Cringely/ESP-Matter-Daikin-S21/Custom PCB esp32c6/3dmodels/XIAO-ESP32-C6-DIP.step

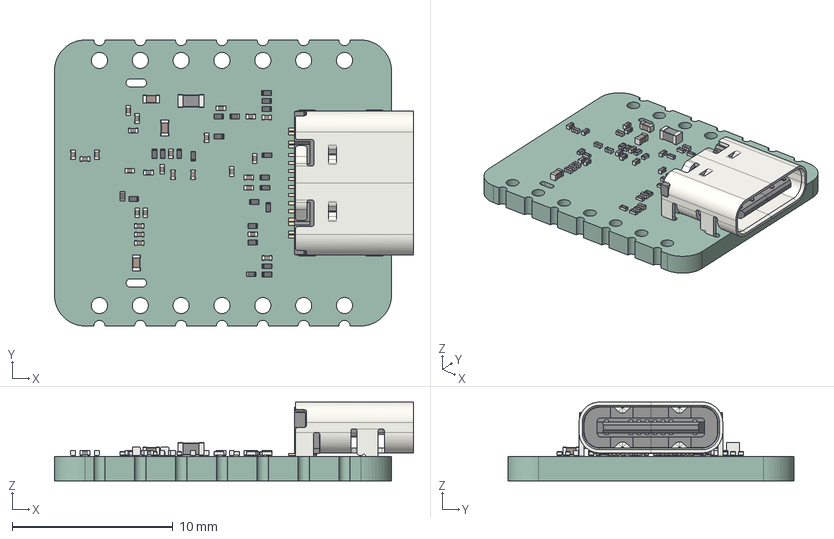
[picture p1: CAD file, 2026-07-21]
Custom PCB esp32c6/3dmodels/XIAO-ESP32-C6-DIP.step
22.3 x 17.8 x 4.91 mm
C_0201_0603Metric x 23
C_0402_1005Metric x 3
R_0201_0603Metric x 22
L_0201_0603Metric x 4
USB_C_Receptacle_16P_TopMnt_Horizontal_GCT_USB4105-xx-A
L_0603_1608Metric
XIAO ESP32 C6_PCB
