Cringely/ESP-Matter-Daikin-S21/Custom PCB esp32c6/fab-xiao/esp32c6_daikin-schematic.pdf

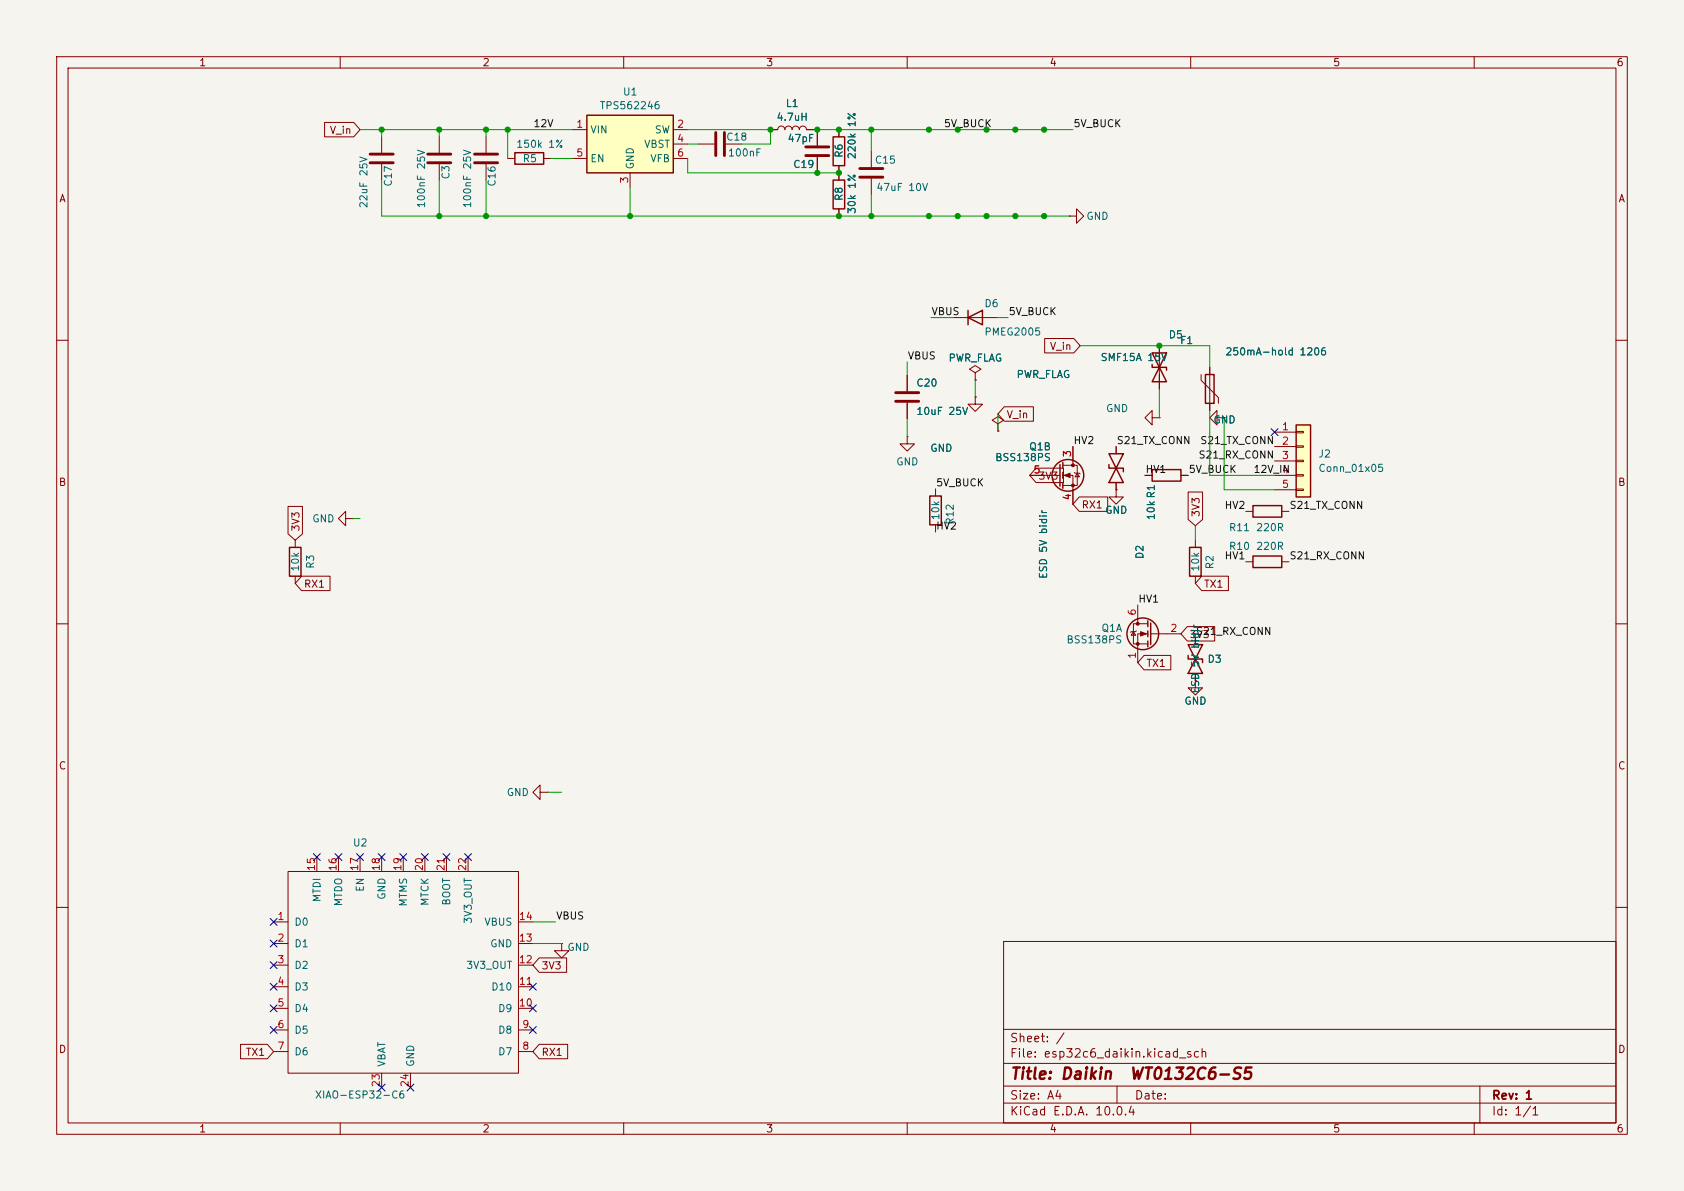
[picture p7: page 1]

Size: A4 | Rev: 1
KiCad E.D.A. 10.0.4 | Id: 1/1
