Cringely/ESP-Matter-Daikin-S21/Custom PCB esp32c6/esp32c6_daikin.kicad_pcb

## KiCad design Custom PCB esp32c6/esp32c6_daikin.kicad_pcb (2026-07-21)

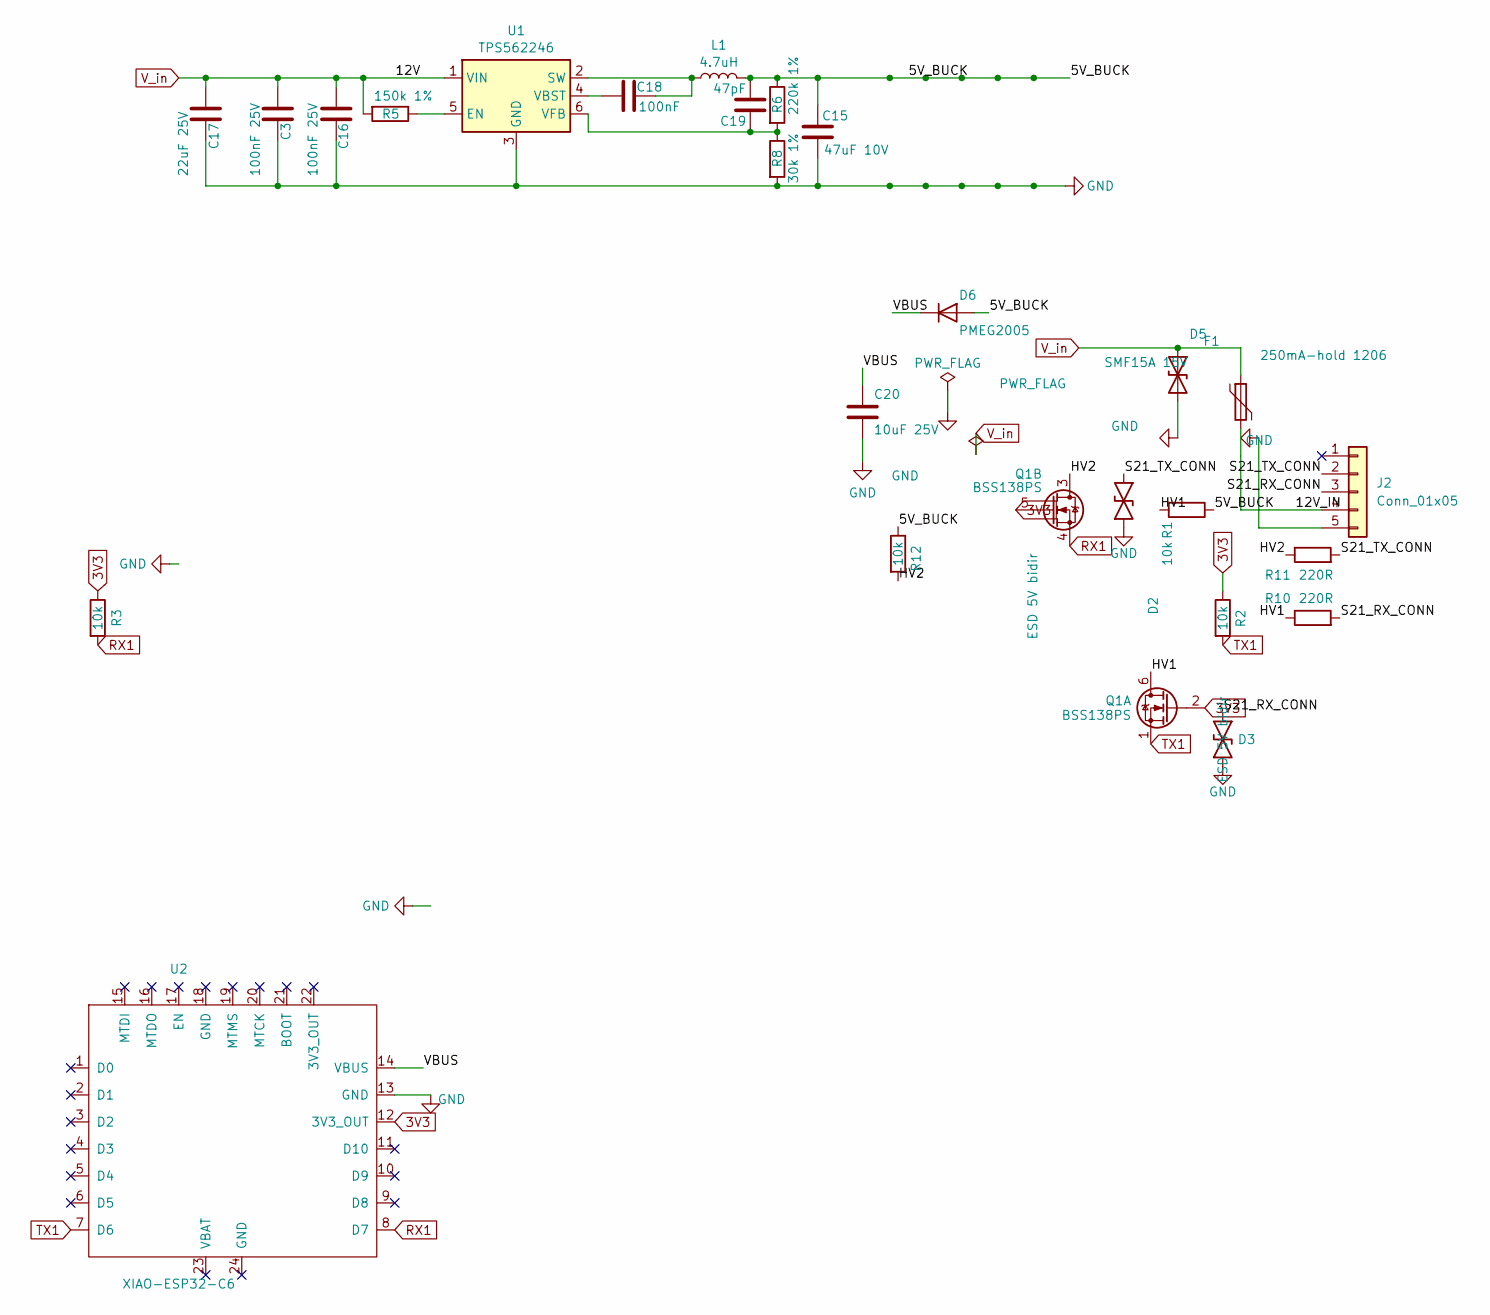
[picture p8: schematic esp32c6_daikin.kicad_sch, Daikin WT0132C6-S5]

Parts:
C3, C16: 100nF 25V; C0402; LCSC C307331
C15: 47uF 10V; C0805; LCSC C2292827
C17: 22uF 25V; C0805; LCSC C398931
C18: 100nF; C0402; LCSC C1525
C19: 47pF; C0402; LCSC C84706
C20: 10uF 25V; C0805; LCSC C15850
D2, D3: ESD 5V bidir; DFN1006-2L_L1.0-W0.6-P0.65-BI; MPN C5137770; LCSC C5137770
D5: SMF15A 15V; D_SOD-123F; LCSC C123802
D6: PMEG2005; D_SOD-123; LCSC C96233
F1: 250mA-hold 1206; Fuse_1206_3216Metric; LCSC C99561
J2: Conn_01x05; JST_EH_S5B-EH_1x05_P2.50mm_Horizontal; LCSC C265103
L1: 4.7uH; IND-SMD_L4.9-W4.9_NRS50XX; LCSC C307876
Q1: BSS138PS; SOT-363_L2.0-W1.3-P0.65-LS2.1-BR; MPN C193381; LCSC C193381
R1, R2, R12: 10k; R0402; MPN C25744; LCSC C25744
R3: 10k; R0402; LCSC C25744
R5: 150k 1%; R0603; LCSC C22807
R6: 220k 1%; R0603; LCSC C22961
R8: 30k 1%; R0402; LCSC C138008
R10, R11: 220R; R_0603_1608Metric; LCSC C1226
U1: TPS562246; SOT-5X3-6_L1.6-W1.2-P0.50-LS1.6-BR; LCSC C41833479
U2: XIAO-ESP32-C6; XIAO-ESP32-C6-DIP

Connections:
3V3: Q1.2 (GN), Q1.5 (GP), R2.1, R3.1, U2.12 (3V3_OUT)
/5V_BUCK: C15.1, C19.2, D6.2 (A), L1.2, R1.1, R6.1, R12.1
/12V_IN: F1.2, J2.4
/HV1: Q1.6 (DN), R1.2, R10.1
/HV2: Q1.3 (SP), R11.1, R12.2
/S21_RX_CONN: D3.2, J2.3, R10.2
/S21_TX_CONN: D2.2, J2.2, R11.2
/VBUS: C20.1, D6.1 (K), U2.14 (VBUS)
GND: C3.2, C15.2, C16.2, C17.2, C20.2, D2.1, D3.1, D5.2 (A2), J2.5, R8.2, U1.3 (GND), U2.13 (GND)
unnamed: R5.1, U1.5 (EN)
unnamed: C18.2, L1.1, U1.2 (SW)
unnamed: C18.1, U1.4 (VBST)
unnamed: C19.1, R6.2, R8.1, U1.6 (VFB)
RX1: Q1.4 (DP), R3.2, U2.8 (D7)
TX1: Q1.1 (SN), R2.2, U2.7 (D6)
V_in: C3.1, C16.1, C17.1, D5.1 (A1), F1.1, R5.2, U1.1 (VIN)

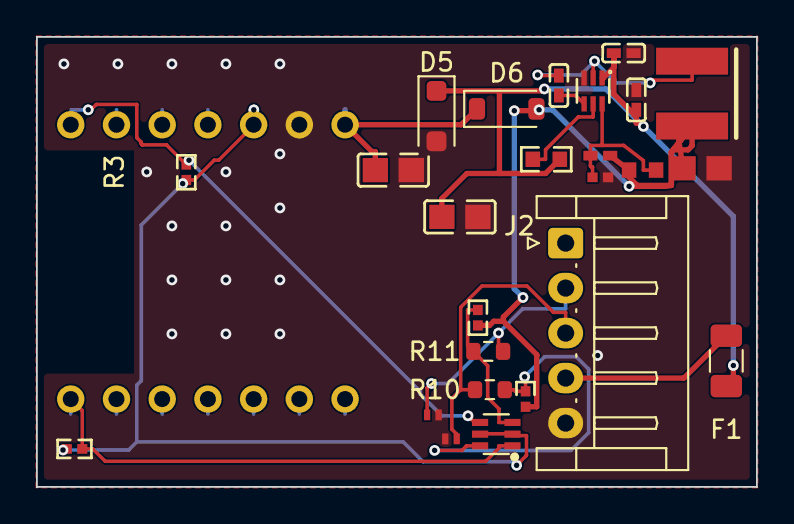
[picture p9: board esp32c6_daikin.kicad_pcb from above]

Board: 2 copper layers, 40.0 x 25.0 mm, 26 parts (1 on the bottom side), 16 nets.
