Cringely/ESP-Matter-Daikin-S21/(commit log)

2026-07-18 fix(drc): enforce 0.127mm minimum clearance and track width
    Board shipped with min_clearance and min_track_width zeroed, so KiCad's
    built-in checks passed vacuously. 0.127mm is the JLC 2-layer floor.
2026-07-18 fix(pcb): replace 91 per-net 1-mil floods with proper GND pours
    EasyEDA-import artifact zones ran 0.0254mm min width, a fifth of the JLC
    floor, risking slivers and coupling the buck SW node into the antenna.
    Routed tracks already carry all nets; only real GND pours remain at
    0.2mm min width with thermal relief.
    [esp32c6_daikin.kicad_pcb]
2026-07-18 fix(pcb): resolve starved thermal reliefs on five GND pads
    [esp32c6_daikin.kicad_pcb]
2026-07-18 fix(pcb): move Boot1 via clear of the board edge
    Sat 0.24mm from Edge.Cuts against a 0.5mm rule; edge routing tolerance
    could nick it. A plain perpendicular retreat wasn't viable: the via sits
    in a 1.05mm corridor between the U2 castellated pad row (0.6mm gaps
    between 2.0mm-pitch pads) and the board edge, too tight to gain edge
    clearance without shorting an adjacent pad. Relocated it into the same-net
    column under U2 pad 12 (161.4,109.03 -> 164.11,108.6) and re-terminated
    the two connected track segments there instead.
    Also hardened refill.py to disable wx assert dialogs (wx.DisableAsserts())
    so a stray pcbnew API nag (PCB_VIA::GetWidth called without a layer
    argument, hit while probing pad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
    [esp32c6_daikin.kicad_pcb]
2026-07-18 fix(sch): add 12V input PTC + TVS and S21 series resistors
    TPS562246 is 17V-rec/19V-abs-max on a 12-14V rail with no clamp; SMF15A
    clamps hot-plug ring near breakdown, under abs-max. PTC protects the
    aircon supply. 220R series resistors cap fault current into the level
    shift, per faikin32 baseline BOM.
    [esp32c6_daikin.kicad_sch]
2026-07-18 feat(sch): S21-standard keyed JST-EH connector
    Replaces the non-keyed 7-pin 0.1in header. Standard Daikin BRP069B41
    lead mates directly; keying provides the reverse-mate protection.
    Debug UART pins dropped; module USB covers debug.
    [esp32c6_daikin.kicad_sch]
2026-07-18 fix(bom): LCSC part numbers for all placeable parts
    U2 and J2 shipped blank and would arrive unplaced from JLC assembly.
    New protection parts included. BOM_rev-b.csv is the assembly BOM.
    [BOM_rev-b.csv, esp32c6_daikin.kicad_sch, task7-bom.csv]
2026-07-18 fix(pcb): place/route 12V protection + S21 series resistors; remove old header
    Sync + place + route the protection parts (F1 polyfuse, D5 SMF15A TVS,
    R10/R11 S21 series resistors) into the PCB and route them to existing copper.
    Old 7-pin J2 header is REMOVED in this commit rather than the connector
    commit: its courtyard and THT pads span x[173.87..186.17] over the full
    board height and occupy the only viable placement region for the protection
    parts. Any parts-first layout with the header present is DRC-verified to
    produce courtyard_overlap + shorting_items errors. The intermediate board
    state therefore has no connector by design; commit B adds the JST-EH and
    routes it to these parts. (Grou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
    [esp32c6_daikin.kicad_pcb]
2026-07-18 feat(pcb): JST-EH connector placement and routing
    Add the 5-pin JST-EH (S5B-EH horizontal) J2 on the right board edge, housing
    and keying facing off-board, pin1 at top. Route to the protection parts placed
    in commit A: J2.4->F1 (12V_IN, F.Cu), J2.2->R10 (S21_TX_CONN, B.Cu w/ one
    F.Cu via-hop over RX), J2.3->S21_RX_CONN (B.Cu), J2.5->GND (F.Cu pour); J2.1 NC.
    Removed 17 GND stitching vias from the connector rework region (x177.7-178.5,
    y90.5-104) that formed a wall between the connector pins and the protection
    parts. GND stays fully connected via the continuous F.Cu pour + the remaining
    stitching vias (DRC unconnected==0 confirms).
    Removed 7 stale old-header silk pin labels (GND/V_in/TX1/RX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
    [esp32c6_daikin.kicad_pcb]
2026-07-18 fix(sch+pcb): separate the two S21 signal nets merged by the JST-EH swap
    The Task-6 JST-EH connector swap merged two S21 nets into one, tying
    J2 pin 2 (aircon Tx) and J2 pin 3 (aircon Rx) together through R10 (220R)
    and feeding the ESP's TX back into its RX front end. A single wire carrying
    the /S21_RX_CONN label at the R10.1 row shorted J2.3, R11.2, and the
    Q1.2/D3/D4 gate cluster onto one 6-node net.
    This restores the Task-5 (commit 2981aef) two-net split, adapted to the new
    JST-EH pin numbers:
    - /S21_TX_CORE (new label; was Net-(D4-K)) = {R10.1, Q1.2, D3.2, D4.1}
    - /S21_RX_CONN (reduced to) = {J2.3, R11.2}
    J2.2 and J2.3 now share no path except through the intended ful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
    [esp32c6_daikin.kicad_pcb, esp32c6_daikin.kicad_sch]
2026-07-19 chore(rev-b): fab package (gerbers + drill + pos) for the module board record
    Design is DRC-clean and reviewed; generated the fab package to answer
    whether rev-b was truly fab-ready (it is, at the design level). The
    board is superseded by the XIAO carrier (see faikin32 spec), so rev-b
    stays as a record with its complete fab package attached.
    [esp32c6_daikin-B_Courtyard.gbr, esp32c6_daikin-B_Cu.gbl, esp32c6_daikin-B_Fab.gbr, esp32c6_daikin-B_Mask.gbs, esp32c6_daikin-B_Paste.gbp, esp32c6_daikin-B_Silkscreen.gbo, esp32c6_daikin-Edge_Cuts.gm1, esp32c6_daikin-F_Courtyard.gbr]
2026-07-19 feat(xiao-sch): delete WT0132C6 module + button circuitry
    [esp32c6_daikin.kicad_sch]
2026-07-19 feat(xiao-sch): add XIAO ESP32-C6 symbol + both-capable footprint
    Add U2 = Seeed XIAO ESP32-C6, reusing the reference designator freed
    by the Task 2 module deletion. Not wired yet (Tasks 4/5 wire UART and
    power); pins left ready.
    Source: official Seeed OPL KiCad library (Seeed-Studio/OPL_Kicad_Library,
    "Seeed Studio XIAO Series Library"). Symbol XIAO-ESP32-C6-SMD (24 pins)
    and footprint XIAO-ESP32-C6-DIP copied verbatim into a project-local lib
    (lib/Seeed_Studio_XIAO_Series.kicad_sym, lib/Seeed_XIAO.pretty) with new
    sym-lib-table / fp-lib-table.
    Footprint is both-capable by construction: each of the 14 main edge pads
    has BOTH a plated through-hole (header/socket mount) and an outward SMD
    e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
    [esp32c6_daikin.kicad_sch]
2026-07-19 feat(xiao-sch): non-inverting AN10441 level shifter + XIAO UART
    Replace the old common-source (INVERTING) BSS138PS shifter with the
    hardware-validated non-inverting NXP AN10441 gate-shifter, and wire the
    XIAO ESP32-C6 UART + power.
    Per channel: gate->3V3, source->LV (TX1/RX1, 10k pull-up to 3V3),
    drain->HV (10k pull-up to 5V_BUCK) -> 220R (R10/R11) -> J2. Crossed so
    XIAO TX (D6) drives aircon Rx (J2 pin3) and aircon Tx (J2 pin2) drives
    XIAO RX (D7). Firmware stays invert:false.
    - Q1 rewired to AN10441; all vestiges of the inverting wiring removed
    (Q1 source/drain no longer to GND; old /S21_TX_CORE + Q1B-SP nets gone).
    - Four 10k pull-ups: R2/R3 kept on 3V3 (LV), R1 repurposed + R12 added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
    [esp32c6_daikin.kicad_sch]
2026-07-19 fix(xiao-sch): correct FET-2 source/drain swap in level shifter
    Q1 (BSS138PS dual N-MOSFET) channel 2 had RX1/HV2 on the wrong pins.
    The RevK symbol names pin 3 "SP" and pin 4 "DP" as if pin3=source,
    pin4=drain, but the Nexperia BSS138PS datasheet Table 2 gives the
    physical pinout as pin 3 = Drain 2, pin 4 = Source 2 (symbol names are
    transposed vs the datasheet). Task 4 wired channel 2 by the symbol's
    names, so the low-voltage line (RX1) landed on the physical drain and
    the 5V line (HV2) on the physical source, backwards for an AN10441
    shifter and opposite to the correct channel 1.
    Fix: swap the two labels at Q1 pins 3/4 so RX1 (LV, to XIAO D7) sits on
    pin 4 (physical Source 2) and HV2 (HV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
    [esp32c6_daikin.kicad_sch]
2026-07-19 feat(xiao-sch): buck 5V re-tune, VBUS isolation diode, cap re-home
    Re-tune TPS562246 buck 3.3V->5.0V, split the merged 3V3 net, add the
    USB-back-feed isolation Schottky, and clear all ERC errors (29->0).
    Divider (datasheet SLUSFG8A Vref=0.600V typ, Table 7-2 5V row):
    R6 150k->220k, R8 33k->30k, C19 18pF->47pF => Vout=0.600*(1+220/30)=5.000V.
    Note: the brief's "Vref~0.804V, Vout~4.46V" premise was wrong; Vref is 0.600V
    and the old divider gave 3.33V (this was a 3.3V buck). Confirmed 5V within the
    0.6-7V output range and 12V within the 4.2-17V input range.
    Net split (verified by netlist node-set, not coordinates):
    Buck-output rail label 3V3(global)->5V_BUCK(local), merging with R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
    [esp32c6_daikin.kicad_sch]
2026-07-19 fix(xiao-sch): drop dead-end ferrite, decouple XIAO VBUS with C20
    FB1 (ferrite) fed C20 in a shunt off 5V_BUCK that dead-ended at GND -
    it filtered nothing downstream, flagged by two EDA reviewers. Deleted
    FB1 and re-homed C20 to decouple the XIAO VBUS pad (post-Schottky D6)
    instead: C20.1 -> VBUS, C20.2 -> GND (unchanged).
    Also cleaned up 10 dangling wire-endpoint stubs left from the Task 5
    buck-rail rehoming (verified via ERC ground truth, not just the
    approximate coordinate list in the task brief - found a 5th affected
    column the brief missed), and corrected U1's stale TPS562246
    description (580kHz/0.804V-7V -> 1.28MHz/0.6V-7V per datasheet
    SLUSFG8A) that had misled an earlier review.
    N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
    [esp32c6_daikin.kicad_sch]
2026-07-19 feat(xiao-pcb): place XIAO + kept parts on grown outline
    Sync the PCB to the reviewed XIAO-carrier schematic (Task 7, placement only;
    routing is Task 8).
    - Remove 12 footprints no longer in the netlist (Reset1, Boot1, Matter1, D4,
    R9, C1, C2, C4, C5, C6, C7, C8).
    - Swap U2 from the old module footprint (easyeda2kicad:WT0132C6-S5) to the
    Seeed XIAO land pattern (Seeed_XIAO:XIAO-ESP32-C6-DIP).
    - Add the 3 new parts: U2 XIAO, D6 (PMEG2005 VBUS Schottky, D_SOD-123),
    C20 (10uF XIAO VBUS decap), R12 (10k). No ferrite (dropped in schematic).
    - Reassign every pad net from the exported netlist (89 pads, 0 mismatches,
    full ref-set parity).
    - Grow the outline to 40x25 mm. Place U2 on B.Cu at t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
    [esp32c6_daikin.kicad_pcb, xiao-task7-padnet-parity.csv]
2026-07-19 fix(xiao-pcb): sync board value fields + footprint lib ids to schematic
    Follow-up to 542d1fc, from independent review. The net-level sync propagated
    nets and footprints but not component value fields, leaving four parts with
    stale rev-b values on the board:
    - R6 150k -> 220k (buck feedback divider; sets Vout)
    - R8 33k -> 30k (feedforward)
    - C19 18pF -> 47pF (feedforward cap)
    - C15 47uF 6V3 -> 47uF 10V (output cap voltage rating)
    These are the Task-5 buck retune values (Vout 5.000 V per TI Table 7-2). A BOM
    cut from the PCB would otherwise place the wrong buck parts. Values now match
    the schematic netlist for all 26 footprints.
    Also set the library nicknames on the two lib-loade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
    [esp32c6_daikin.kicad_pcb, xiao-task7-padnet-parity.csv]
2026-07-19 fix(xiao-pcb): extend antenna keep-out to cover on-board antenna projection
    XIAO_antenna_keepout only extended to x=150.82 (0.82mm inside the board
    edge at x=150). Seeed does not publish an exact antenna dimension for the
    XIAO ESP32-C6 onboard ceramic antenna (checked wiki.seeedstudio.com getting-started
    page, forum antenna-comparison thread, and the bundled Seeed_XIAO footprint,
    none give a figure); Espressif's ESP32-C6 PCB layout guideline only gives a
    15mm end-product enclosure clearance, not a carrier-board copper keepout.
    Using the conservative XIAO-family convention (antenna region occupies the
    outer 5-6mm of the 21mm module) plus margin: keepout now runs to x=155.5,
    about 6.5mm in fro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
    [esp32c6_daikin.kicad_pcb]
2026-07-19 fix(xiao-pcb): notch antenna keep-out clear of TX1/RX1 pad rows
    Re-review found the prior keepout extension (150.82->155.5, full board
    depth) engulfed U2.7/TX1 and U2.8/RX1 pad copper at x=151.88: every
    routing escape from those pads crossed the tracks-not-allowed zone,
    making them unroutable in Task 8.
    Reworked to a T-shaped polygon: full-depth band only to x=150.3 (0.36mm
    clear of the widest TX1/RX1 pad edge at x=150.664, > 0.3mm min), then
    extended coverage to x=155.5 only in the y=92.2-104.8 center band between
    the two pad rows (measured pad-row inner edges 105.358 top / 91.642
    bottom, 0.56mm clearance each side, > 0.5mm min). Trades full-width
    antenna coverage near the board edge for r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
    [esp32c6_daikin.kicad_pcb]
2026-07-19 fix(xiao-pcb): move center-gap passives out of antenna keep-out
    Re-review flagged R1, R2, C16 as a Task 7 placement defect, not a Task 8
    routing note: parts sitting under the antenna region is poor RF practice
    independent of the keepout's tracks/copperpour ban. Verified by geometry
    (pad + courtyard bboxes vs the keepout polygon, both rule-area rects) that
    these three were the complete offender set beyond U2 itself.
    Relocated, preserving layer/orientation:
    - R1 (5V_BUCK/HV1, shifter HV-side pull-up) to (177.147,106.118), next to
    the Q1/R10/R11 shifter cluster it belongs to.
    - R2 (3V3/TX1 pull-up) to (152.089,108.891), just off U2's bottom edge,
    ~2.4mm from the TX1 pad it serves, clear of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
    [esp32c6_daikin.kicad_pcb]
2026-07-19 fix(xiao-pcb): re-place buck support passives per datasheet layout
    Move C3/C17 input caps, C18 bootstrap, R6/R8/C19 feedback divider,
    C15 output cap tight to U1/L1 in the top-right buck cluster; C20 VBUS
    cap to the XIAO VBUS pin; R12 pull-up to the HV2 node at Q1/R11.
    Clears the XIAO center-gap of buck nets (root cause of the prior
    2-net routing block) and shortens SW/bootstrap/feedback loops per the
    TPS562246 layout guidance. Placement DRC (courtyard/short) clean.
    [esp32c6_daikin.kicad_pcb]
2026-07-20 fix(xiao-pcb): unseal U1 VFB pad exit (nudge C16 east 0.4mm)
    The VFB sense pin U1-6 was physically sealed at OSH Park 6-mil clearance:
    its only lateral exit (rightward) was pinched between the C18-2/SW pad halo
    (right edge 181.645, +0.2286 halo = 181.874) and the C16-1/V_in pad halo
    (left edge 182.009, -0.2286 halo = 181.780). The two halos overlapped
    (181.780 < 181.874), leaving no gap, so no trace or via could leave the pad.
    Three independent routers (maze, Freerouting push-shove x10 runs, A* finisher)
    plus closed-form geometry all confirmed U1-6 could not be exited.
    Fix: move C16 (VIN input decoupler) 0.4mm east, 182.279 -> 182.679 (x only,
    y unchanged). This opens a 0.306mm (2x trace-wi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
    [esp32c6_daikin.kicad_pcb]
2026-07-20 fix(xiao-pcb): re-layout buck cluster with per-net routing corridors
    The TPS562246 (U1, SOT-23-6, 0.5mm pitch) buck cluster could not route at
    the board's 0.2mm track-to-pad DRU rule: three middle/edge pins (SW, EN, VFB)
    over-subscribed a single ~0.3mm corridor. Re-laid out the cluster so each hard
    pin gets its own >=0.2mm-clean escape, budgeted geometrically before placing.
    U1 kept at 180.9,89.0 rot90; corridors cleared:
    - SW (U1-2, top-mid) exits up into a clear strip y[86.5,87.8] -> C3 moved off
    the SW column: C3 180.9,87.05 -> 181.9,86.9 (VIN cap now above VIN pin U1-1).
    - EN (U1-5) / VFB (U1-6) / VBST (U1-4) exit down into a cleared fan-band
    y[90.3,92.3] -> the FB divider + bootst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
    [esp32c6_daikin.kicad_pcb]
2026-07-20 feat(xiao-pcb): route, pour, DRC clean, OSH Park 6-mil verified
    Full 2-layer routing on the re-laid-out buck cluster. All 15 signal/power nets
    route at the board's own DRU rules (0.2mm track-to-pad, 0.127mm track-track,
    0.33mm track-to-hole, 0.3mm edge). Power nets (5V_BUCK, VBUS, V_in, 12V_IN)
    on a Power netclass at 0.3mm width. Antenna keep-out respected (no tracks in
    the polygon); TX1/RX1 escape through the keep-out notch; S21 traces clear of L1.
    GND: solid pour both layers, stitched with vias, single connected plane tied to
    the star point J2-5; F.Cu island under the buck output tied through a via.
    Toolchain (portable, not committed): Freerouting 2.2.4 on Temurin JRE 25.0.3+9,
    DSN/SES v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
    [esp32c6_daikin.kicad_pcb]
2026-07-20 test(xiao-pcb): commit OSH Park 6-mil DRC evidence
    Review found the 6-mil verification ran only in scratch space with no
    committed artifact. Reproduced on a byte-identical copy of the eda8131
    board with all custom clearance rules and both netclass clearances
    patched to 0.1524mm: 0 violations, 0 unconnected. Method note documents
    the rule-patch set, superseding the earlier floor-only check.
2026-07-20 review(xiao-pcb): delegated DFM review
    Apply the two required fixes from the delegated pcb-dfm-reviewer pass
    (verification/xiao-pcb-review.md, verdict READY-WITH-FIXES) before
    gerber export.
    F1: dedupe stacked stitching vias. 17 GND stitch points each carried
    6 co-located identical vias (0.3mm drill / 0.6mm pad), 85 redundant
    drill hits total. Kept one via per location: 124 -> 39 vias (17 GND
    stitch + 22 signal). Eliminates all 199 holes_co_located warnings.
    F2: delete dangling stub on /5V_BUCK. Removed the reviewer-identified
    4.868mm F.Cu run (183.432,100.262)-(179.989,103.705). Deleting it
    exposed a second segment (179.989,103.705)-(177.769,103.705), 2.221mm,
    that was only "terminated" b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
    [esp32c6_daikin.kicad_pcb]
2026-07-20 fix(xiao-sch): assign D2/D3 sourceable values
    D2/D3 protect the S21 TX/RX lines to GND (LCSC C5137770 = GOODWORK
    ES05D1MC10, bidirectional 5V ESD/TVS, DFN1006-2L). Value fields were
    blank; set to 'ESD 5V bidir'. Metadata only, no wiring change: netlist
    node-sets byte-identical (36 nets, 0 changed), ERC 0 errors, DRC
    schematic-parity 0.
    [esp32c6_daikin.kicad_sch]
2026-07-20 fix(xiao-sch): correct stale rev-b LCSC part numbers
    The XIAO board inherited four LCSC assignments from rev-b whose parts no
    longer match the updated values, plus one obsolete part. JLC and any
    regenerated BOM assemble by LCSC number, so these would mis-build the board:
    R6 C22807 (150k) -> C22961 (220k 1% 0603) buck FB top, sets Vout
    R8 C25779 (33k) -> C138008 (30k 1% 0402) buck FB bottom, sets Vout
    C15 C16780 (6.3V) -> C2292827 (47uF 10V 0805) buck out; 6.3V fails DC-bias
    C19 C1549 (18pF) -> C84706 (47pF C0G 0402) buck feedforward
    C17 C45783 (obsolete) -> C398931 (22uF 25V 0805 Murata GRT, in stock)
    Metadata only, no wiring change: netlist node-sets byte-identic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
    [esp32c6_daikin.kicad_sch]
2026-07-20 feat(xiao): fab package + sourceable BOM
    Gerbers (2-layer), Excellon drill, centroid pos CSV, and top/bottom
    renders for the XIAO ESP32-C6 carrier, exported with kicad-cli 10.0.4 at
    the DRC-clean board. Plus BOM_xiao.csv: every SMD part carries an LCSC
    number and a web-verified DigiKey/Mouser cross; the XIAO module (U2) is
    marked DNP-by-fab / hand-assembled.
    Note: gerbers are provisional. A silkscreen cleanup pass will touch the
    board file after this lands; regenerate gerbers from the post-silk board
    before uploading to a fab. Copper/drill/placement are final.
    [BOM_xiao.csv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]
2026-07-20 fix(xiao-pcb): silkscreen legibility pass + fab package refresh
    Drove all silkscreen DRC to zero and fixed U2's undersized reference
    designator, then regenerated the fab package. Silk graphics and
    reference text only; no copper, tracks, vias, or zones changed.
    DRC warnings (full run) before -> after:
    silk_overlap 55 -> 0
    silk_over_copper 29 -> 0
    silk_edge_clearance 2 -> 0
    text_height 1 -> 0
    text_thickness 1 -> 0
    Residual non-silk warnings are pre-existing/expected and non-gating:
    19 lib_footprint_issues, 2 hole_to_hole, plus 1 new lib_footprint_mismatch
    (U2's board-embedded footprint silk was edited so it no longer matches
    its library copy - intended).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
    [esp32c6_daikin-B_Courtyard.gbr, esp32c6_daikin-B_Cu.gbl, esp32c6_daikin-B_Fab.gbr, esp32c6_daikin-B_Mask.gbs, esp32c6_daikin-B_Paste.gbp, esp32c6_daikin-B_Silkscreen.gbo, esp32c6_daikin-Edge_Cuts.gm1, esp32c6_daikin-F_Courtyard.gbr]
2026-07-20 fix(xiao): correct D5 DigiKey cross + BOM sourcing notes
    D5: SMF15ALFCT-ND does not exist at DigiKey (fabricated); replaced with
    F5817CT-ND, the verified Littelfuse SMF15A cross for the LCSC MDD-brand
    primary (C123802).
    C15: DK P/N column cited the 15L reel-variant number under a 15K MPN;
    these are distinct DigiKey part numbers, not a formatting difference.
    Harmonized to the 15K DK number matching the sourced MPN.
    D6: noted DK 1157665 backorder status; LCSC C96233 remains in stock.
    J2: noted canonical DK 455-1628-ND alongside the 455-S5B-EH-ND alias
    (both verified to resolve to the same JST S5B-EH right-angle header).
    [BOM_xiao.csv]
2026-07-20 chore(xiao): final-review metadata cleanup
    Applies the mechanical items from final review that survived verification:
    1. LCSC fields added: D6 -> C96233, C20 -> C15850 (metadata only).
    2. NOT applied. Review flagged two micro wire stubs (0.0127mm/0.0254mm,
    UUIDs 30fba69b.../d927969b...) as unconnected_wire_endpoint ERC
    warnings safe to delete. Verified false: each stub is the sole
    graphical connection for a GND power symbol (#PWR06, #PWR017).
    Deleting them leaves those pins with zero attached wires, which
    flips ERC from 0 errors/72 warnings to 2 errors (pin_not_connected).
    The <nets> netlist section is unaffected either way (power-symbol
    global-label net forms independ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
    [esp32c6_daikin.kicad_sch]
2026-07-20 fix(xiao-pcb): clear keep-out boundary via, enforce no-vias in antenna zone
    Prior review claimed XIAO_antenna_keepout was via-free, so flipping its
    keepout vias allowed -> not_allowed was believed copper-inert. False:
    GND stitch via 326f1585 sat at (155.5, 93.5), exactly on the zone's
    right edge (x=155.5, y 92.2-104.8). The reviewer's center-point test
    passed because the via's *center* is on the boundary line, not inside
    the polygon; DRC's actual check tests full pad/via copper extent
    (0.6mm diameter disc), which straddles the edge and triggered
    items_not_allowed the moment vias were disallowed.
    Fix: moved the via 0.6mm east to (156.1, 93.5), same GND stitching
    net/role, position not critic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
    [esp32c6_daikin.kicad_pcb]
2026-07-20 chore(xiao): regenerate fab package after keep-out via fix
    Via 326f1585 moved east of the antenna keep-out (060567f) reflowed both
    GND pours; gerbers, drill, pos, and renders re-exported so the committed
    package matches HEAD copper exactly.
    [esp32c6_daikin-B_Courtyard.gbr, esp32c6_daikin-B_Cu.gbl, esp32c6_daikin-B_Fab.gbr, esp32c6_daikin-B_Mask.gbs, esp32c6_daikin-B_Paste.gbp, esp32c6_daikin-B_Silkscreen.gbo, esp32c6_daikin-Edge_Cuts.gm1, esp32c6_daikin-F_Courtyard.gbr]
2026-07-21 fix(xiao-sch): schematic legibility pass
    Text/layout-only pass; electrical design untouched. Moved refdes/value
    fields and power-symbol GND/PWR_FLAG text out of overlapping piles into
    open space; reoriented rotated-symbol fields (D5/F1/R10/R11) to read
    horizontally; fixed XIAO TX1 label overrunning the D6 pin name and the
    3V3/GND collision on pins 12-13; decluttered the V_in/PWR_FLAG/GND stub
    corner.
    Regions cleaned: buck input (already clean, verified), protection cluster
    value/refdes piles, V_in/flag stub corner, XIAO U2 pin labels.
    Residual: the J2 connector net-label band (S21_TX_CONN/S21_RX_CONN/HV1/
    HV2/12V_IN/5V_BUCK) remains dense. Each net carries three load-bearing
    labels sitting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
    [esp32c6_daikin.kicad_sch]
2026-07-21 fix(xiao-pcb): FB cluster spacing to real margins + mask-web enforcement
    Open the two tightest buck-feedback pad gaps to real v1 margins and turn on
    the OSH Park mask-web floor so DRC enforces it.
    Item A (copper):
    - C19.2<->R6.1 (both /5V_BUCK): 0.100mm -> 0.269mm (target >=0.25).
    - R8.2<->R6.1 (GND vs /5V_BUCK): 0.230mm -> 0.480mm (target >=0.30).
    R6 is boxed on all four sides (C19 N same-net, R8 W GND, C15 E, and the
    5V_BUCK output web S at y94.1). R6-south and C19-north/west both re-seal a
    corridor (the 5V_BUCK output web / the VFB sense trace). The clean move is
    R6 + C15 east 0.25mm together, shifting the 5V_BUCK output east-wall track
    (+0.30) and translating the VFB feed segment east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
    [esp32c6_daikin.kicad_pcb]
2026-07-21 fix(xiao-sch): J2 label band symbol repositioning
    The connector label band garbled: same-net 11-char labels on adjacent stubs
    (two "S21_TX_CONN" on J2 pin2's row, two "S21_RX_CONN" on pin3's row) overlapped
    because R10/R11 (the 220R pull-ups) sat directly in the connector label lane,
    each adding a duplicate net label that collided with the J2 pin label.
    Relocate R11 and R10 out of the lane to their own rows below the connector,
    carrying their pin labels (HV2/S21_TX_CONN, HV1/S21_RX_CONN) with them, and flip
    the J2 pin labels' justify so they read into the vacated lane instead of over the
    connector body. Both resistors connect only via net-name labels on their pins (no
    attached wires), so re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
    [esp32c6_daikin.kicad_sch]
2026-07-21 chore(xiao): regenerate fab package + renders
    Regenerate the full fab package from the final board (FB-cluster spacing +
    mask-web enforcement) and schematic (J2 band repositioning):
    - gerbers/ RS-274X set + Excellon drill + job file
    - esp32c6_daikin-xiao.pos.csv placement/centroid
    - xiao-render-top.png / -bottom.png board renders
    - esp32c6_daikin-schematic.pdf
    Copper, mask, placement, renders, and schematic PDF all reflect the polished
    board and schematic. Upload the gerbers to the fab, not the .kicad_pcb.
    [esp32c6_daikin-B_Courtyard.gbr, esp32c6_daikin-B_Cu.gbl, esp32c6_daikin-B_Fab.gbr, esp32c6_daikin-B_Mask.gbs, esp32c6_daikin-B_Paste.gbp, esp32c6_daikin-B_Silkscreen.gbo, esp32c6_daikin-Edge_Cuts.gm1, esp32c6_daikin-F_Courtyard.gbr]
2026-07-21 feat(xiao): xlsx BOM for US assembly quoting
    Screaming Circuits requires xlsx BOM format. Grouped one line per part
    type (20 lines, 26 placements), qty + refdes list + mfr + MPN + DigiKey/
    Mouser P/N, U2 marked DO NOT PLACE (customer-installed XIAO module).
    Generated from BOM_xiao.csv; CSV remains the source of truth.
    [BOM_xiao.xlsx]
2026-07-21 feat(xiao): JLCPCB-format BOM and CPL
    JLC's processor rejects raw KiCad pos/BOM formats. CPL matches their
    sample schema exactly (mm-suffixed Mid X/Y, Y negated positive, Top/
    Bottom, integer rotation); BOM uses Comment/Designator/Footprint/LCSC.
    U2 excluded from both (customer-installed XIAO). Generated from the
    CSV sources of truth.
    [BOM_xiao_jlc.xlsx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]
2026-07-21 fix(xiao): C17 to Murata GRM21BR61E226ME44L (LCSC C86816)
    User-selected at JLC assembly order; prior C398931 unavailable in their
    matcher. Same 22uF/25V/X5R/0805 class, verified on JLC part page.
    Regenerated xlsx and JLC-format BOMs from the CSV source.
    [BOM_xiao.csv, BOM_xiao.xlsx, BOM_xiao_jlc.xlsx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]
2026-07-21 feat(xiao): sync BOM to as-ordered JLC assembly parts
    Order finalized 2026-07-21, 5 boards. Fee-free swaps verified by research
    pass: D2/D3 H5VL10B (5V bidir 15pF), D5 Hongjiacheng SMF15A, D6 B0520W
    (Vf~385mV parametric, datasheet check flagged). C17/C19/R8/R10/R11 moved
    to in-stock Basic parts, R8 corrected to 30k after a 1k mismatch in the
    matcher. C15 stays Murata C2292827 (only 47uF/10V option with published
    DC-bias data). Original design parts retained in notes as DigiKey
    sourceable alternates. Placement-preview polarity check passed for
    D5/D6/U1/Q1 against board pad nets.
    [BOM_xiao.csv, BOM_xiao.xlsx, BOM_xiao_jlc.xlsx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]
2026-07-21 docs(xiao): D6 B0520W Vf verified from datasheet curve
    [BOM_xiao.csv, BOM_xiao.xlsx]
2026-07-21 feat(xiao): XIAO 3D model + assembled renders, refresh fab zip
    Derive a XIAO ESP32-C6 STEP model from Seeed's own officially
    published KiCad PCB design source (wiki resources zip) via
    kicad-cli pcb export step, re-centered on the module's own board
    outline. Seeed's own kicad footprint library (OPL_Kicad_Library /
    the wiki KiCad-Library zip) ships the XIAO-ESP32-C6-DIP footprint
    with broken ${AMZPATH} 3D model references pointing at other XIAO
    variants (nRF52840/SAMD21/RP2040/ESP32-C3/ESP32S3), none C6-specific
    and none resolvable; those are removed and replaced with the
    derived model. Seeed's own wiki 3D-model link for the C6 resolves
    to a login-gated third-party GrabCAD upload, not a first-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
    [XIAO-ESP32-C6-DIP.step, esp32c6_daikin.kicad_pcb]
2026-07-21 docs(xiao): correct order status to cart-staged, not placed
    The JLC walkthrough was a part-picking exercise; no order has been
    placed. Prior commit dc99918's 'order finalized' wording overclaimed.
    Part selections remain valid; stock and matcher results must be
    re-verified at actual order time.
    [BOM_xiao.csv, BOM_xiao.xlsx, BOM_xiao_jlc.xlsx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]
